alwynallan/redoubler/circuit/REDOUBLER BOM.ods

Sheet: REDOUBLER
REDOUBLER Parts | Package | Qty | Supplier | Sup. P/N | Manufacturer | Manufacturer P/N | Order Qty | Price Ea. | Order Cost | Unit Cost | Comment
Microcontroller PSoC 5LP | 68-QFN | 1 | DigiKey | CY8C5666LTI-LP005-ND | Cypress | CY8C5666LTI-LP005 | 1 | $10.6500 | $10.65 | $10.65 | 4 opamps, 1 SAR DAC, $9.20 qty 25
10.0K 1% resistor | 0402 | 4 | DigiKey | 311-10.0KLRCT-ND | Yageo | RC0402FR-0710KL | 100 | $0.0060 | $0.60 | $0.02
9.53K 1% resistor | 0402 | 4 | DigiKey | 311-9.53KLRCT-ND | Yageo | RC0402FR-079K53L | 100 | $0.0060 | $0.60 | $0.02 | Lower gain one notch
22 Ohm 1% resistor | 0402 | 2 | DigiKey | 311-22.0LRCT-ND | Yageo | RC0402FR-0722RL | 100 | $0.0060 | $0.60 | $0.01
.1uF bypass capacitor | 0402 | 8 | DigiKey | 490-6319-1-ND | Murata | GRM155R70J104KA01D | 250 | $0.0090 | $2.25 | $0.07 | Cheaper than bypass-specific
1uF ceramic X5 capacitor | 0402 | 3 | DigiKey | 490-1320-1-ND | Murata | GRM155R60J105KE19D | 100 | $0.0163 | $1.63 | $0.05
Bright White 3.1 Vf LED | 0603 | 1 | DigiKey | 1516-1080-1-ND | QT Brightek | QBLP617-IW | 10 | $0.3020 | $3.02 | $0.30
USB A Connector | SMD | 1 | DigiKey | 931K-ND | Keystone | 931 | 10 | $0.79 | $7.90 | $0.79
Enclosure |  | 1 | Mouser | 789-P3A-140703-U | New Age Encl. | P3A-140703-U | 10 | $1.80 | $18.00 | $1.80 | BUD part from DigiKey with larger PCB area
Board |  | 1 | OSH Park | Custom |  |  | 9 | $1.08 | $9.75 | $1.08
 |  |  |  |  |  |  |  | Totals | $55.00 | $14.81

Sheet: Just_Digikey
Qty | PN
2 | 428-3229-ND
4 | CY8C5666LTI-LP005-ND
250 | 311-10.0KLRCT-ND
100 | 311-22.0LRCT-ND
250 | 490-6319-1-ND
100 | 490-1320-1-ND
10 | 1516-1080-1-ND
10 | 931K-ND
1 | 428-2975-ND
2 | 428-3344-ND
2 | WM4203-ND
1 | SMD291AX10-ND
25 | YAG1307CT-ND
