alwynallan/redoubler/(threads)

Thread 1 (2016-06-25):

Modular Entropy Multiplication?

BurtHarris, 2016-06-25:
This is very interesting, I was considering prototyping something similar using a CY8CKIT-059 I have sitting around unused.   I'm glad I found your project, thank you Peter.

I'm interested why you use the term MEM to describe it.   It doesn't seem to involve modular arithmetic, have I missed something?

alwynallan, 2016-06-25:
Hi Burt,

I have made this work on at CY8KIT-059, but there are some minor issues:

   - Two of the pins that I used in REDOUBLER have capacitors connected
   between them and ground, so they wouldn't work as-is. For me it was easier
   to reassign to other GPIO pins, than to remove the capacitors. You'll see
   the change in the attached PNG file, and the updated firmware is also there.
   - The REDOUBLER uses a 3.3V regulator to get clean power, but the
   CY8KIT-059 uses the 5V USB power directly. Noise on the power lines can
   cause the generator to temporarily lock up, producing hundreds of 1's or
   0's (I forget which) in a row. This lock-up can be made less likely by
   lowering the loop gain below 2.0, and that is the reason for the 9.53K
   resistors that you mentioned. On CY8KIT-059 I would go further to 9.1K or
   even 8.2K for those resistors.
   - The LED supplied with CY8KIT-059 is on a different pin, referenced to
   ground, and much dimmer than the one I used. I made firmware changes to
   correct for these things.

The name MEM is a bit of a compromise. Bill Cox invented
<https://github.com/waywardgeek/infnoise> this method of generating random
bits independently form me (I was first, but I kept it secret to preserve
patent rights. He published it, and I have since disavowed any patent
interest.) Bill has an explanation of how this is like mod-2
multiplication, and that led to the name.

GMail won't accept the attachment, so the files you need are here:

http://apa.hopto.org/REDOUBLER_DIY.zip

A. Peter Allan · 450 Timber Lane · Devon PA 19333 · 610-687-1708 ·
610-547-4836 mobile

On Sat, Jun 25, 2016 at 12:35 PM, Burt Harris <notifications@github.com>
wrote:

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

BurtHarris, 2016-06-25:
Thank you Peter, that looks pretty easy, I'll give it a shot.

BurtHarris, 2016-06-27:
Success.   I've assembled one, built the software, and flashed it.   Smoke test succeeded (no smoke), and I can see "audio" input coming from the device.   I've[ forked the project ](https://github.com/BurtHarris/redoubler-diy#redoubler-diy) to track your CY8KIT-059 code variant, and any changes I make.   Have a look at the photo.

Thank you.

Closed 2016-06-27.

Thread 2 (2016-06-25):

Broken link for OSH Park board source

BurtHarris, 2016-06-25:
Clicking the "OSH Park" link just below the board image in the Readme file takes me to a 404 error at https://oshpark.com/shared_projects/GZnEjhlQ

alwynallan, 2016-06-25:
The design has had some iterations since I updated the GitHub. The latest
files are attached. You can drag-and-drop the .brd file to OSHPark to get
them made.

I had poor yield (~50%) producing these in my workshop. I think solder
bridges under the tiny chip caused most problems. I understand that is
normal with these packages, and that professional assemblers do much better
(98+%).

I was tempted to take it into production but the horror show of ONERNG
<https://www.kickstarter.com/projects/moonbaseotago/onerng-an-open-source-entropy-generator/updates>
scared me from it - he had everything from fake components to legionnaire's
disease. Luckily I'm not supporting myself with these interests; I'm an
investor.

A. Peter Allan · 450 Timber Lane · Devon PA 19333 · 610-687-1708 ·
610-547-4836 mobile

On Sat, Jun 25, 2016 at 12:54 PM, Burt Harris <notifications@github.com>
wrote:

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

Closed 2016-06-28.

Thread 3 (2016-06-25):

Solderless breadboard implementation?

BurtHarris, 2016-06-25:
I've got a couple of CY8CKIT-059 modules handy, is there any reason I shouldn't be able to breadboard the external resistors in order to try this out?

alwynallan, 2016-06-25:
Solderless breadboards have unreliable connections and lots of stray pin
capacitance. With a $10 CY8KIT-059 I would solder the 8 resistors to it.
Here's how mine looks:

A. Peter Allan · 450 Timber Lane · Devon PA 19333 · 610-687-1708 ·
610-547-4836 mobile

On Sat, Jun 25, 2016 at 12:58 PM, Burt Harris <notifications@github.com>
wrote:

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

BurtHarris, 2016-06-25:
Sure, understood.

Closed 2016-06-25.

Thread 4 (2016-06-25):

10 K ohm vs 9.53K ohm

BurtHarris, 2016-06-25:
The schematic diagram in the readme shows the values of R4, R6, R8, and R10 as 9.53K, but the block diagram shows these as all 10K.   Is this critical?

alwynallan, 2016-06-25:
My early prototypes had all 10K resistors and no voltage regulator. I found
frequent glitches in the data, depending on the quality of the power. Bill
Cox had the same experience with his similar circuit, and solved it by
reducing gain using 8.2K in the feedback path. He had a 3.3V regulator all
along. The cost is that the random bits become more correlated (less
entropy per bit) as the gain is reduced below 2.0.

I found that 9.53K with a regulator avoided problems in all cases that I
tested. A lower resistor value would avoid problems more reliably.

Let me know if I missed something, or new questions come up.

A. Peter Allan · 450 Timber Lane · Devon PA 19333 · 610-687-1708 ·
610-547-4836 mobile

On Sat, Jun 25, 2016 at 1:06 PM, Burt Harris <notifications@github.com>
wrote:

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

BurtHarris, 2016-06-25:
Thank you

Closed 2016-06-25.

Thread 5 (2016-06-28):

Doesn't seem to be working.

BurtHarris, 2016-06-28:
Hi Peter,

When I plug my DIY version into USB, it enumerates as a microphone, and the light starts up when I start monitoring the microphone's levels' but listening to it through PC speakers sounds like a square wave.   Similarly when I probe the external resistors around the op amps I see square wave at about 19.23 Hz,  4.8V peak-to-peak.

I tried both 8.2K and 9.1K resistors paired with the 10K's per your diagram.   at the op amps I should be seeing something more like the scope-like traces you put in the README, right?

I'm thinking there may be something wrong with the clock generation that is feeding the S/H's.   Any ideas or suggestions?

P.S. the blue LED on the board is flickering, but the pulse width is rather narrow, so it doesn't get very bright.  It is at least interesting in that the pulse width in varying.

BurtHarris, 2016-06-28:
S/H clocks are running at 357 KHz which seems in the right ballpark, though a little slow if I calculate 45MHz / 48 / 2.   I'll try looking at the wiring diagram from this fork to see if there might have been something different.

alwynallan, 2016-06-28:
I looked carefully at your photograph at the top of your forked GitHub
page. It looks like you have a pair of resistors connected to *both* GPIOs
3.2 and 3.1, but they should only be connected to 3.1. Similarly, you seem
to have a pair of resistors connected to both 0.3 and 15.5, but they should
only be connected to 15.5.

Maybe you interpreted the black curved arrows in my diagram (repeated
below) as a connection. It was supposed to show where the connection used
to be in REDOUBLER, and where I moved it for REDOUBLER-DIY.

That would explain the fixed frequency oscillation, because the old GPIO
pins (3.2 and 0.3) have capacitors connected on the board for use improving
A/D performance.

When it's working it should look like the traces I showed when connected to
an oscilloscope. I used the internal A/Ds to record the traces, and feed
the data out though a debugger. I would be interested to see how they look
on a scope.

The LED is supposed to flicker randomly when the device is generating bits.

Thanks for keeping me posted.

[image: Inline image 1]

A. Peter Allan · 450 Timber Lane · Devon PA 19333 · 610-687-1708 ·
610-547-4836 mobile

On Mon, Jun 27, 2016 at 11:49 PM, Burt Harris <notifications@github.com>
wrote:

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

BurtHarris, 2016-06-28:
Ahhh.   Yes, I made the black connections into jumpers.
Thank you Peter, I do appreciate your spending the time to help.

BurtHarris, 2016-06-30:
OK.   Rewired as you intended, and I get scope traces a lot closer to the data you plotted, have a look.

The bad news is that more often than not, the sound output more like square wave than random, but pressing reset repeatedly I do sometimes hit a condition where it sounds more like white noise.   Without doing mathematical analysis of the generated bits, I think there's a pattern, and when I look at the "one second worth of data" image in your readme, it seems apparent to me there too.   Sort of a two-dimensional grid of whiter bands.

Thread 6 (2017-03-31):

Integration with Linux

mhalano, 2017-03-31:
On a Debian system I can install the package 'rng-tools5' and use this tool to redirect the entropy from a device (like /dev/video0) to the random device (/dev/random). I was wondering what is the correct device under /dev/ for the microphone.

alwynallan, 2017-04-01:
I don't know exactly how USB microphones work with the Linux /dev/ structure. I always used asound libraries to access it. The linux software provided works with Ubuntu and Raspian, which are both Debian based.

Currently I am working on a major re-write to the firmware, because Cypress no longer supports the USB-Audio codebase, and it won't compile with the latest version of PSoC Creator. The new firmware will connect as a USB CDC terminal, no driver needed, and use a udev rule to mount as /dev/REDOUBLER which can be accessed by rngd (rng-tools). It can also provides optional whitening, and 4x the bitrate, 4Mbps. It can produce a diagnostic page like [this](https://apa.hopto.org/redoubler.html). I'll have both the custom key, and a DIY version that uses Cypress CY8CKIT-059 for $10.

More soon.

Closed 2021-08-24.

Thread 8 (2025-07-08):

Your OSHPark link, to a supposed board, is dead..  : (

libweirdness, 2025-07-08:
( some might suggest that its having been done in EagleCAD, instead of KiCAD, might be a bug, but it was done aeons ago, right?

There was some electronics-engineering blog which identified that using EagleCAD, just because it's the most-popular, is a bug for a completely-different reason..

There is some competitor which has such thorough bug-in-the-design finding rules, that it's a bug to *not* be standardizing on *that*, instead!

I'll see if I can find it, though it's been years since I read that, right now, for you...

hmm..  it *might* have been DipTrace, but the blog I'm referring-to isn't appearing in the search-results, & Autodesk seems to have displaced most competition from the market.. )

Anyways, THANK YOU for having made this work, & if you make the board available anywhere, there are a few people in the world who'll likely care ( if we can only find it: you did this *many* years before I found your work!  Sometimes consolidated internet-search, & the removal of DMOZ directory's significance is a problem, isn't it?

Oh, waitaminite.. DigiKey now offers min-4x PWB/"PCB" builds, don't they?

Ah HA!

( come to think of it, why the HELL isn't Mouser partnering with somebody: *their* market is *exactly* who we experimenters are! : )

---

Salut, Namaste, Kaizen, *& Gratitude* for your work & to-the-world-giving..

_ /\ _
