alwynallan/redoubler/circuit/REDOUBLER.brd.pdf

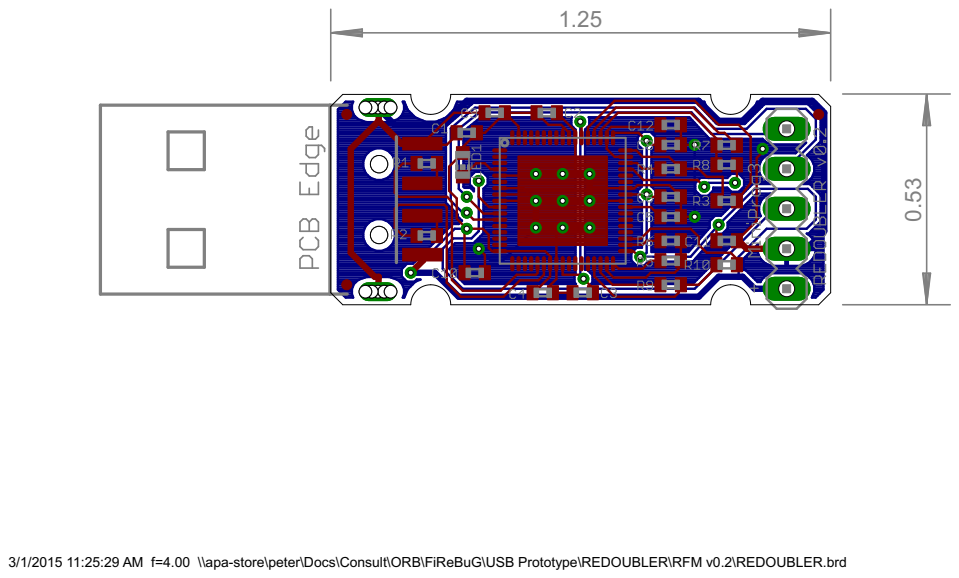
[picture p7: page 1]

3/1/2015 11:25:29 AM f=4.00 \\apa-store\peter\Docs\Consult\ORB\FiReBuG\USB Prototype\REDOUBLER\RFM v0.2\REDOUBLER.brd
