alwynallan/redoubler/circuit/REDOUBLER.sch.pdf

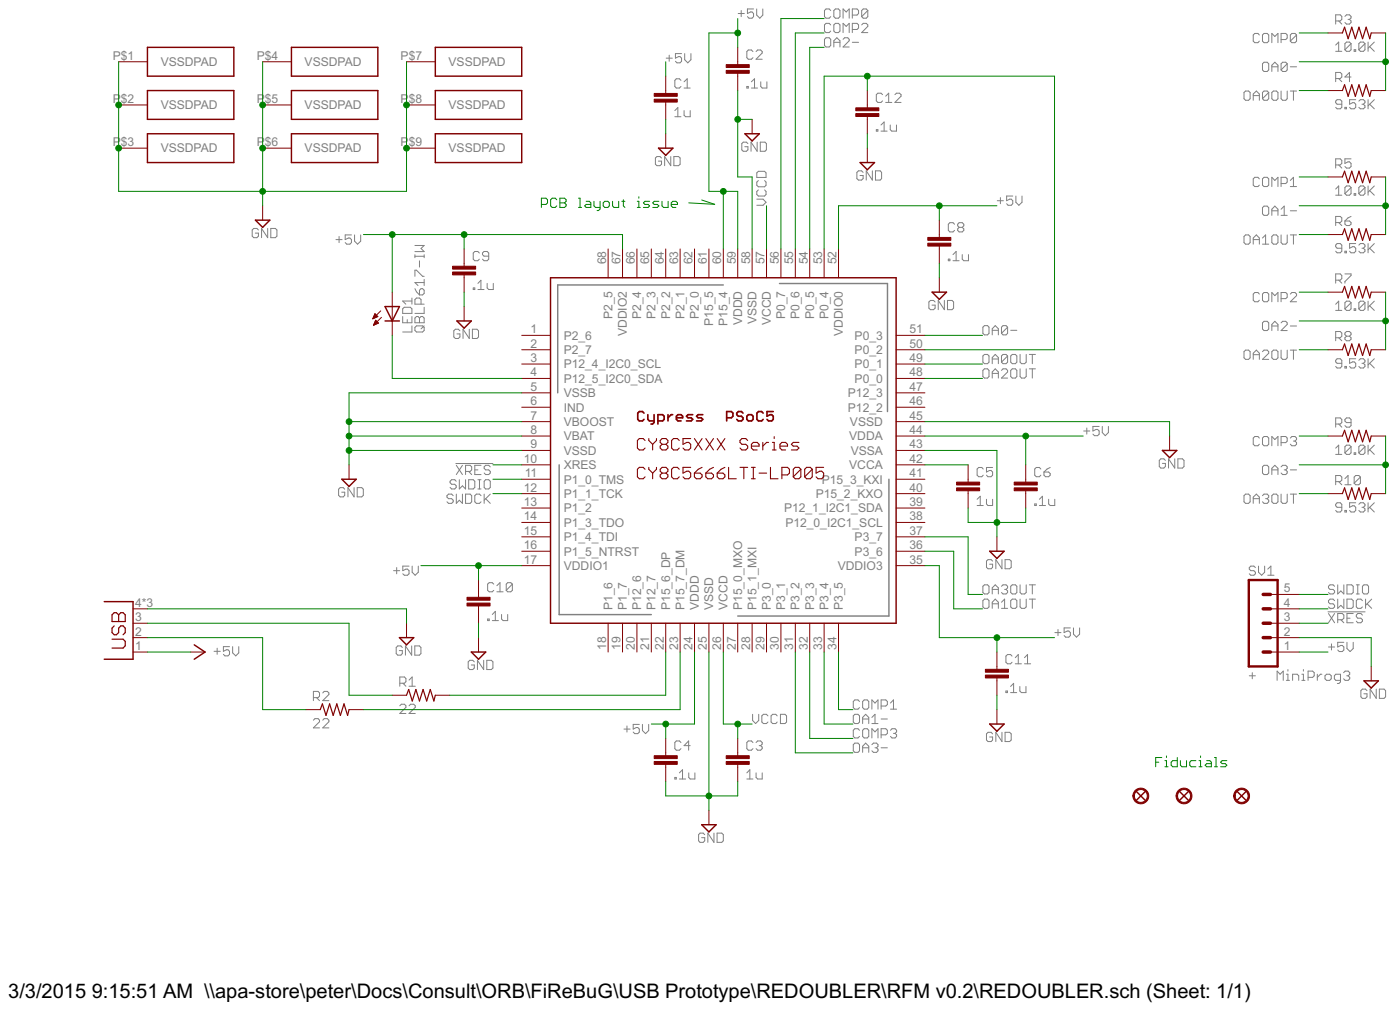
[picture p8: page 1]

3/3/2015 9:15:51 AM \\apa-store\peter\Docs\Consult\ORB\FiReBuG\USB Prototype\REDOUBLER\RFM v0.2\REDOUBLER.sch (Sheet: 1/1)
