alwynallan/redoubler/circuit/REDOUBLER.brd

## EAGLE design circuit/REDOUBLER.brd (2015-03-08)

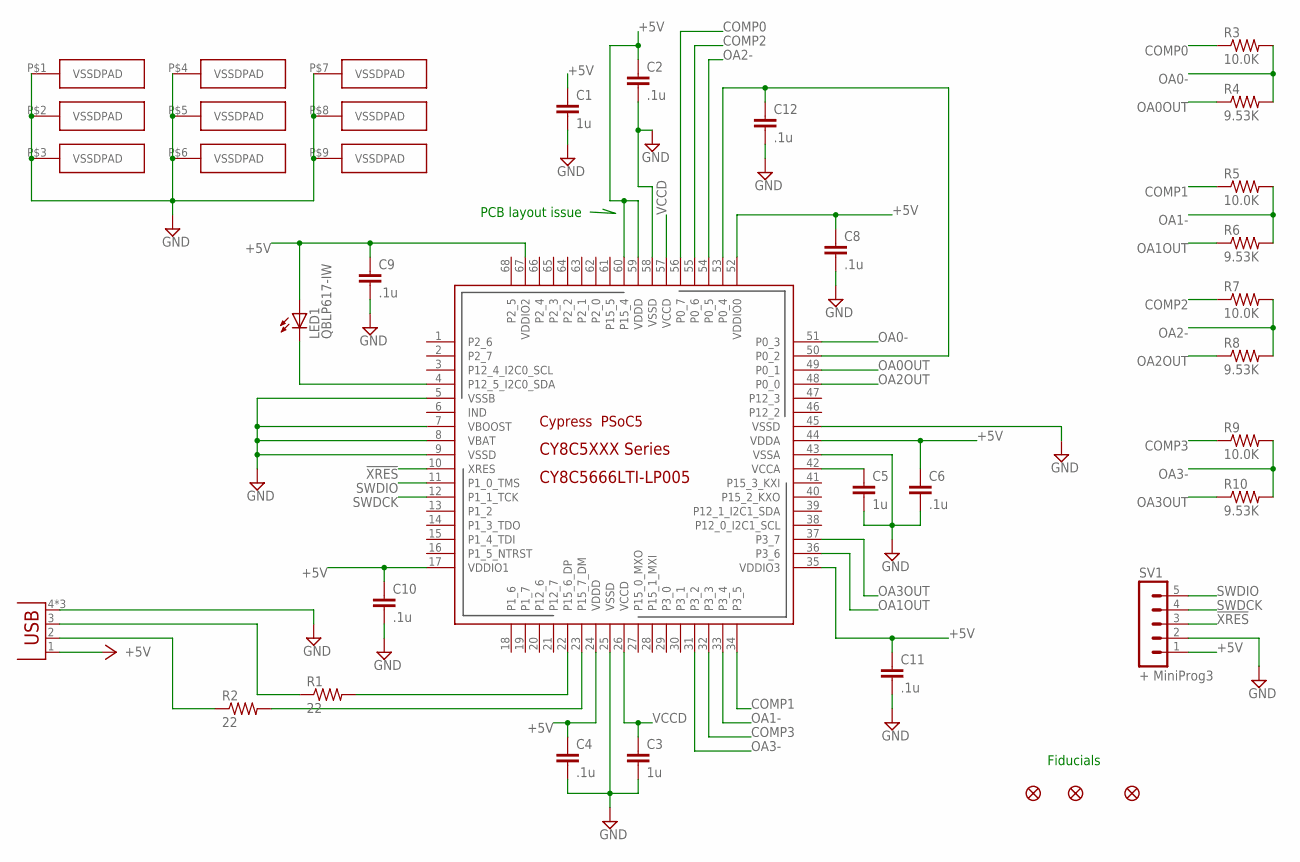
[picture p9: schematic REDOUBLER.sch]

Parts:
C1, C3, C5: 1u; C0402
C2, C4, C6, C8, C9, C10, C11, C12: .1u; C0402
FID1, FID2, FID3: FIDUCIALUFIDUCIAL; MICRO-FIDUCIAL
LED1: QBLP617-IW; CHIP-LED0603
R1, R2: 22; R0402
R3, R5, R7, R9: 10.0K; R0402
R4, R6, R8, R10: 9.53K; R0402
SV1: + MiniProg3; MA05-1
U$1: CY8C5666LTI-LP005; QFN68
X1: USBSMT-MALE; USB-A-SMT-MALE

Connections:
!XRES!: SV1.3, U$1.10 (XRES)
+5V: C1.1, C2.1, C4.1, C6.1, C8.1, C9.1, C10.1, C11.1, LED1.A, SV1.1, U$1.17 (VDDIO1), U$1.24 (VDDD), U$1.35 (VDDIO3), U$1.44 (VDDA), U$1.52 (VDDIO0), U$1.59 (VDDD), U$1.60 (P15_4), U$1.67 (VDDIO2), X1.1 (VCC)
COMP0: R3.1, U$1.56 (P0_7)
COMP1: R5.1, U$1.34 (P3_5)
COMP2: R7.1, U$1.55 (P0_6)
COMP3: R9.1, U$1.32 (P3_3)
GND: C1.2, C2.2, C3.2, C4.2, C5.2, C6.2, C8.2, C9.2, C10.2, C11.2, C12.2, SV1.2, U$1.5 (VSSB), U$1.7 (VBOOST), U$1.8 (VBAT), U$1.9 (VSSD), U$1.25 (VSSD), U$1.43 (VSSA), U$1.45 (VSSD), U$1.58 (VSSD), U$1.P$1 (VSSDPAD), U$1.P$2 (VSSDPAD), U$1.P$3 (VSSDPAD), U$1.P$4 (VSSDPAD), U$1.P$5 (VSSDPAD), U$1.P$6 (VSSDPAD), U$1.P$7 (VSSDPAD), U$1.P$8 (VSSDPAD), U$1.P$9 (VSSDPAD), X1.4 (GND), X1.P$1 (GND), X1.P$3 (GND)
unnamed: C12.1, U$1.50 (P0_2), U$1.53 (P0_4)
unnamed: LED1.C, U$1.4 (P12_5_I2C0_SDA)
unnamed: R1.1, X1.3 (D+)
unnamed: R2.1, X1.2 (D-)
unnamed: R1.2, U$1.22 (P15_6_DP)
unnamed: R2.2, U$1.23 (P15_7_DM)
unnamed: C5.1, U$1.42 (VCCA)
OA0-: R3.2, R4.2, U$1.51 (P0_3)
OA0OUT: R4.1, U$1.49 (P0_1)
OA1-: R5.2, R6.2, U$1.33 (P3_4)
OA1OUT: R6.1, U$1.36 (P3_6)
OA2-: R7.2, R8.2, U$1.54 (P0_5)
OA2OUT: R8.1, U$1.48 (P0_0)
OA3-: R9.2, R10.2, U$1.31 (P3_2)
OA3OUT: R10.1, U$1.37 (P3_7)
SWDCK: SV1.4, U$1.12 (P1_1_TCK)
SWDIO: SV1.5, U$1.11 (P1_0_TMS)
VCCD: C3.1, U$1.26 (VCCD), U$1.57 (VCCD)

Notes on the sheet:
Fiducials
PCB layout issue

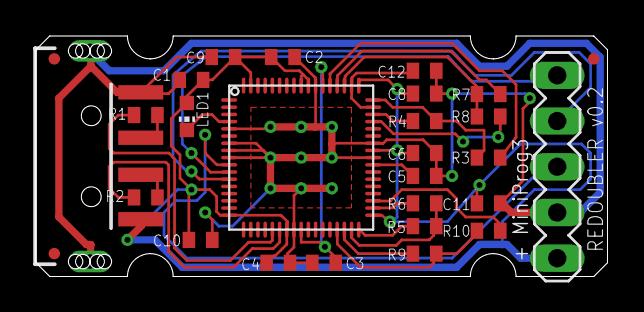
[picture p10: board REDOUBLER.brd from above]

Board: 2 copper layers, 31.8 x 13.4 mm, 28 parts (0 on the bottom side), 25 nets.
