alwynallan/redoubler/psoc_creator_firmware/REDOUBLER.cydsn/device.h

/* ========================================
 *
 * Copyright YOUR COMPANY, THE YEAR
 * All Rights Reserved
 * UNPUBLISHED, LICENSED SOFTWARE.
 *
 * CONFIDENTIAL AND PROPRIETARY INFORMATION
 * WHICH IS THE PROPERTY OF your company.
 *
 * ========================================
*/
#if !defined(DEVICE_H)
#define DEVICE_H
#include <project.h>

#endif

//[] END OF FILE
