alwynallan/redoubler/(commit log)

2015-03-07 Streamline PSoC 5 Firmware
    [Configuration.h]
2015-03-08 Added traces image
2015-03-08 Added circuit
    [REDOUBLER BOM.ods, REDOUBLER BOM.xlsx, REDOUBLER.brd, REDOUBLER.sch]
2015-03-08 Fixed circuit images
2015-03-19 added whiten options and VID/PID
2015-03-27 added xorbits and auto USB voltage detect
2015-04-02 Fixed runs to give same result as pipe
    [runs.c]
